humain-humain/lefeel_music/README.md

## lefeel Music
**Textile device used to create midi note**

###### Description

Lefeel is a research project of teleportation of the touch through a portable textile surface.
We develop a special application to make some music with our textile device

###### Tutorial

We wrote a tutorial to realize this textile device :

[https://humain-humain.github.io/lefeel_music/](https://humain-humain.github.io/lefeel_music/)

###### Credit

- Concept and Design : Humain–Humain (Lucile CROSETTI, Amélie SOUTSAMRAN, Amandine HENAFF, Bastien DIDIER)
- Development : Bastien DIDIER

###### Gallery

lefeel prototype
