humain-humain/lefeel_music/processing/README.md

# lefeel Music version

1 - Add **theMidiBus** library in your processing/libraries/ folder

2 - Change the device port 

```
String device_port = "/dev/cu.usbmodem1421";
```

3 - Run the processing sketch
