humain-humain/lefeel_music/arduino/README.md

# lefeel Music version

1 - Add the Adafruit_MPR121 in your arduino/libraries/ folder

2 - Upload the code in your Arduino
