humain-humain/lefeel_music/docs/img/tuto/axe_config.png

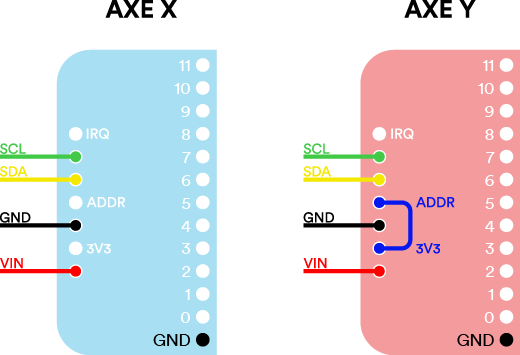
docs/img/tuto/axe_config.png
