humain-humain/lefeel_music/docs/img/tuto/hd/TUTO-lefeel_11.jpg

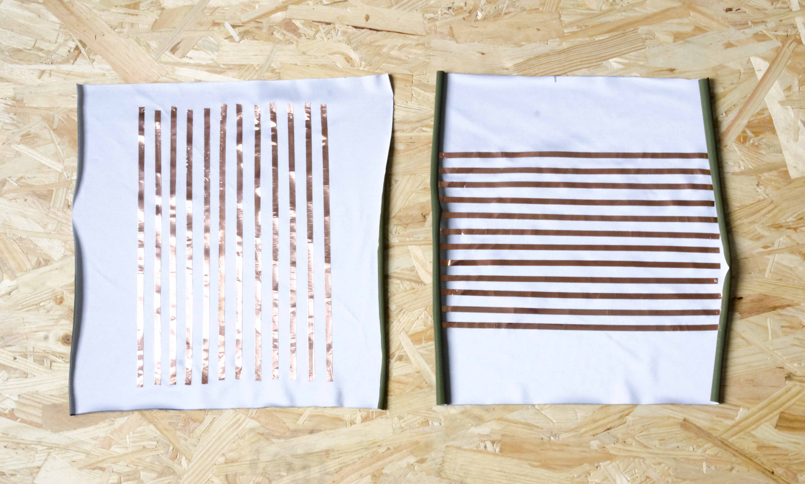
docs/img/tuto/hd/TUTO-lefeel_11.jpg
