humain-humain/lefeel_music/docs/img/tuto/hd/TUTO-lefeel_14.jpg

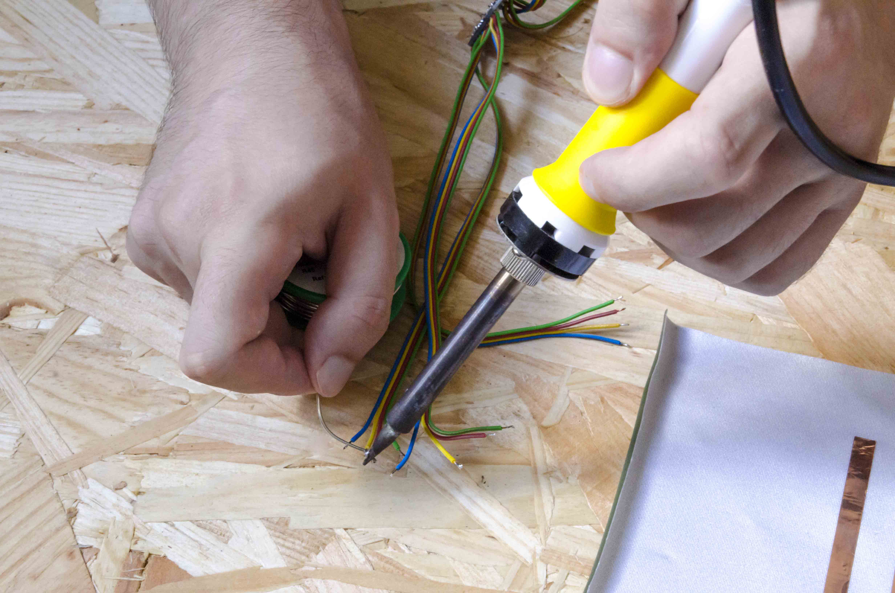
docs/img/tuto/hd/TUTO-lefeel_14.jpg
