humain-humain/lefeel_music/docs/img/tuto/hd/TUTO-lefeel_15.jpg

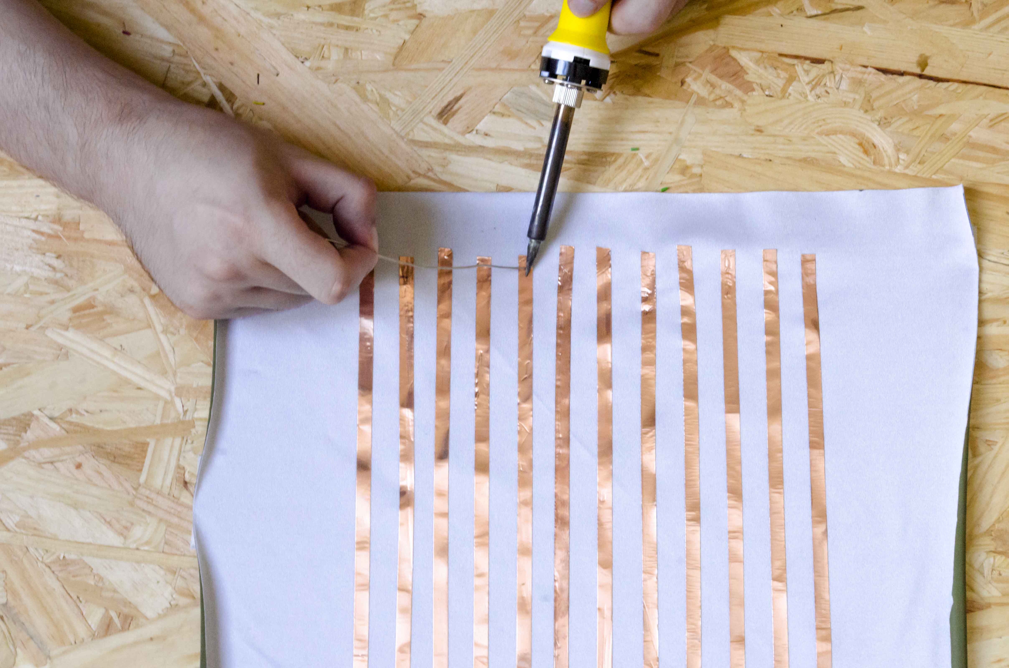
docs/img/tuto/hd/TUTO-lefeel_15.jpg
