humain-humain/lefeel_music/docs/img/tuto/hd/TUTO-lefeel_18.jpg

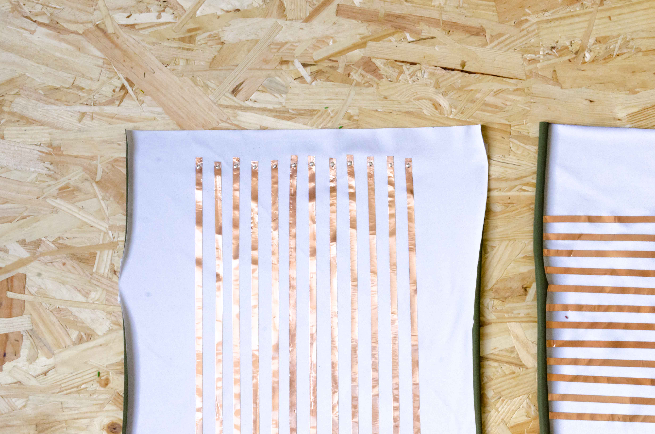
docs/img/tuto/hd/TUTO-lefeel_18.jpg
