humain-humain/lefeel_music/docs/img/tuto/hd/TUTO-lefeel_19.jpg

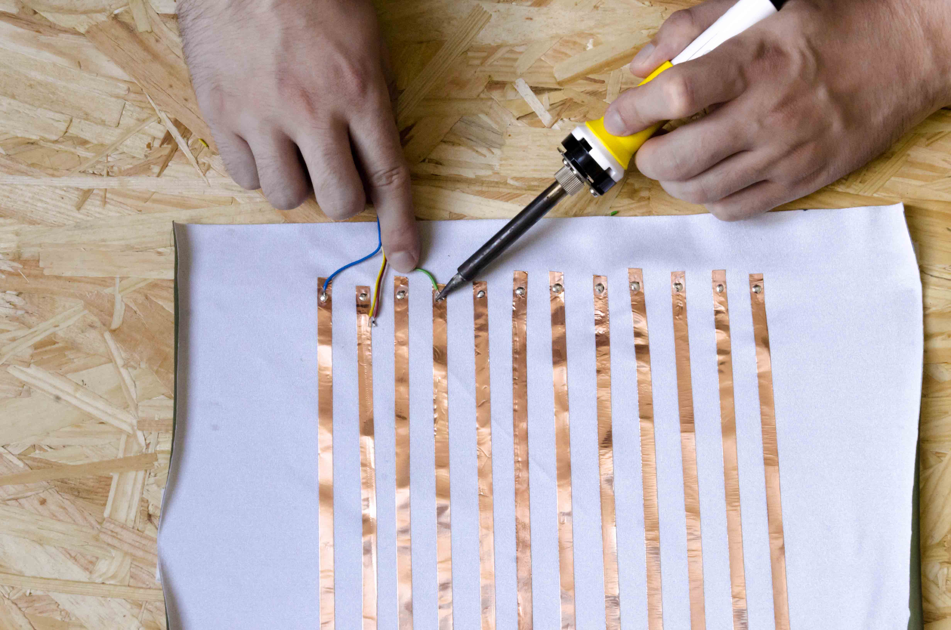
docs/img/tuto/hd/TUTO-lefeel_19.jpg
