humain-humain/lefeel_music/docs/img/tuto/hd/TUTO-lefeel_26.jpg

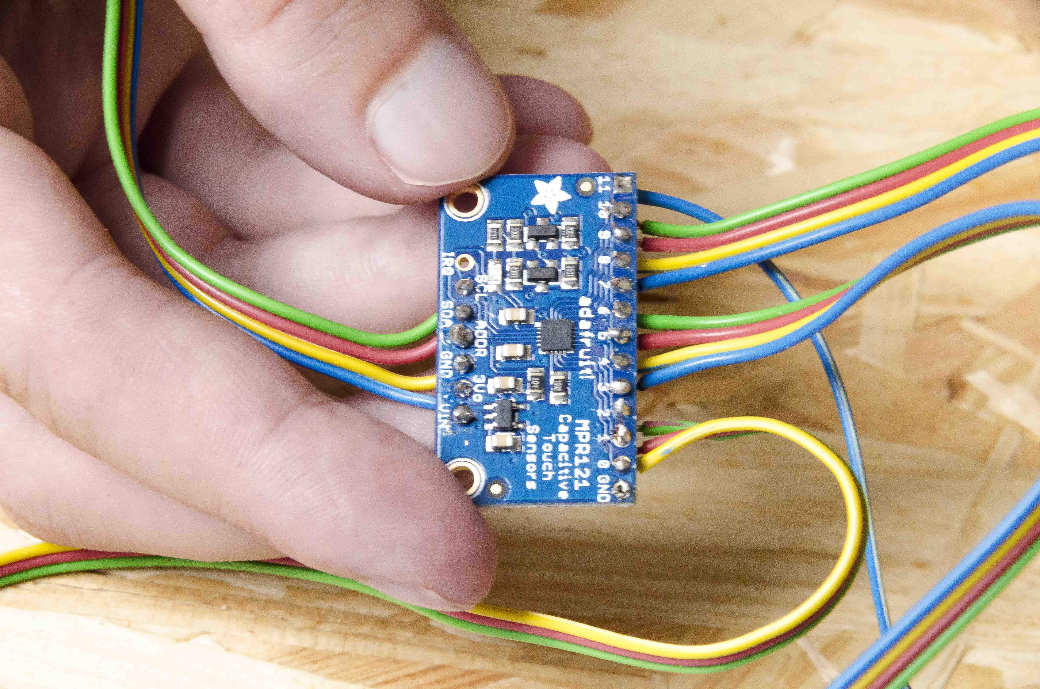
docs/img/tuto/hd/TUTO-lefeel_26.jpg
