humain-humain/lefeel_music/docs/img/tuto/hd/TUTO-lefeel_29.jpg

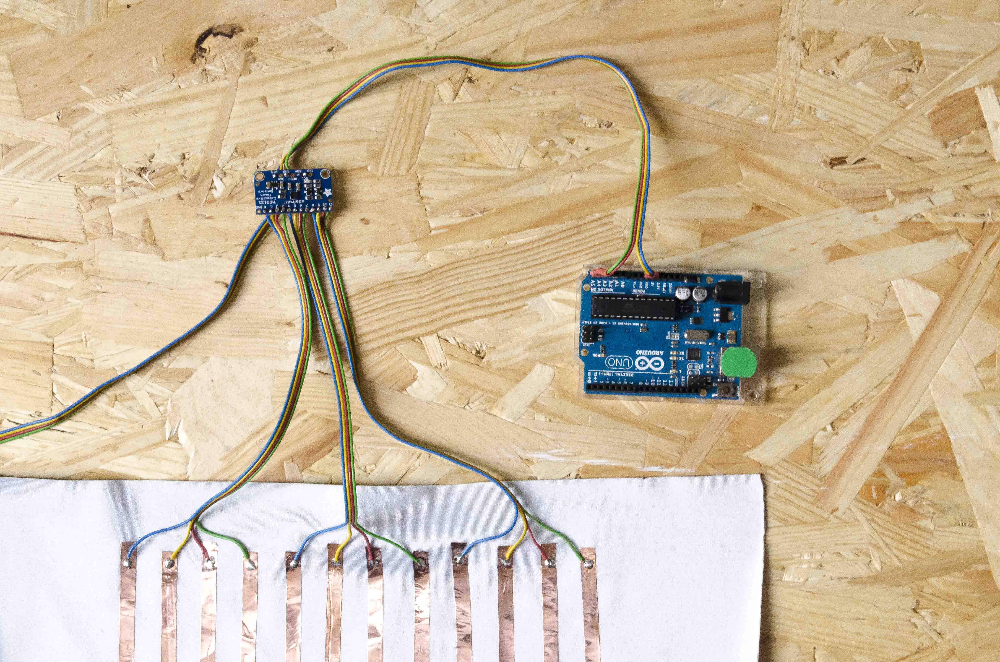
docs/img/tuto/hd/TUTO-lefeel_29.jpg
