humain-humain/lefeel_music/BOM-lefeel-music.pdf

### LeFeel (Music) - Part List

| | Final version : 30 july 2017 Quantity calculated for 1 prototype Created by : Bastien DIDIER
| Number of Kit : | 1
Item | Picture | Component | Units | Unit Price (€) | Total (€) | Description | Example of provider
1 | | Tape | 1 | 4,30 | 4,3 | Copper tape 5mm / 15 m | https://www.gotronic.fr/art-cuivre-adhesif-cu155ad-20730.htm
2 | | Velostat | 1 | 3,54 | 3,54 | Velostat Pressure Sensitive Conductive Sheet | http://www.mouser.fr/ProductDetail/Adafruit/1361/?qs=sGAEpiMZZMtyU1cDF2RqUKfg8pKi7bzlqM8vGXcF50w%3d
3 | | Capacitive Touch | 2 | 7,12 | 14,24 | Touch Sensor Development Tools Capacitive Touch 12-Key Sensor B/O | http://www.mouser.fr/search/ProductDetail.aspx?r=485-1982
| | | | Total (€) : | 22,08

1
