humain-humain/lefeel_music/(commit log)

2017-07-28 add docs initial commit & Arduino Code
2017-07-28 update arduino readme
2017-07-28 Update Docs : How to make a controller Midi with a textile device
2017-08-02 add Bill of materials
